Oissso/Robot_MasterProject/README.md

Librarie doit être ajouter dans Documents/Arduino /!\ ce n'est pas toutes les librairies
