Oissso/Robot_MasterProject/Stage robotique Montage robot jour 1 (1).pdf

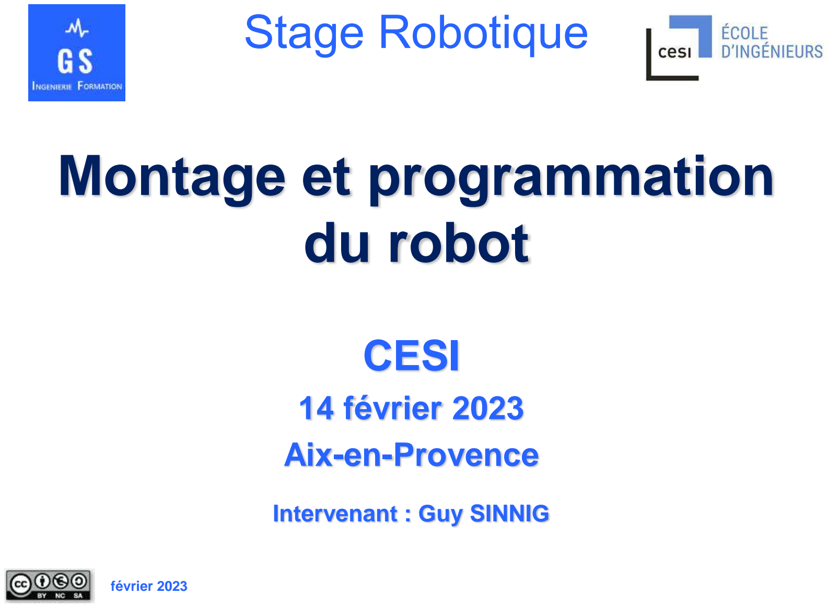
[picture p13: page 1]

février 2023

# Montage et programmation du robot

# CESI

## 14 février 2023 Aix-en-Provence

Intervenant : Guy SINNIG

# Objectif général de la présentation

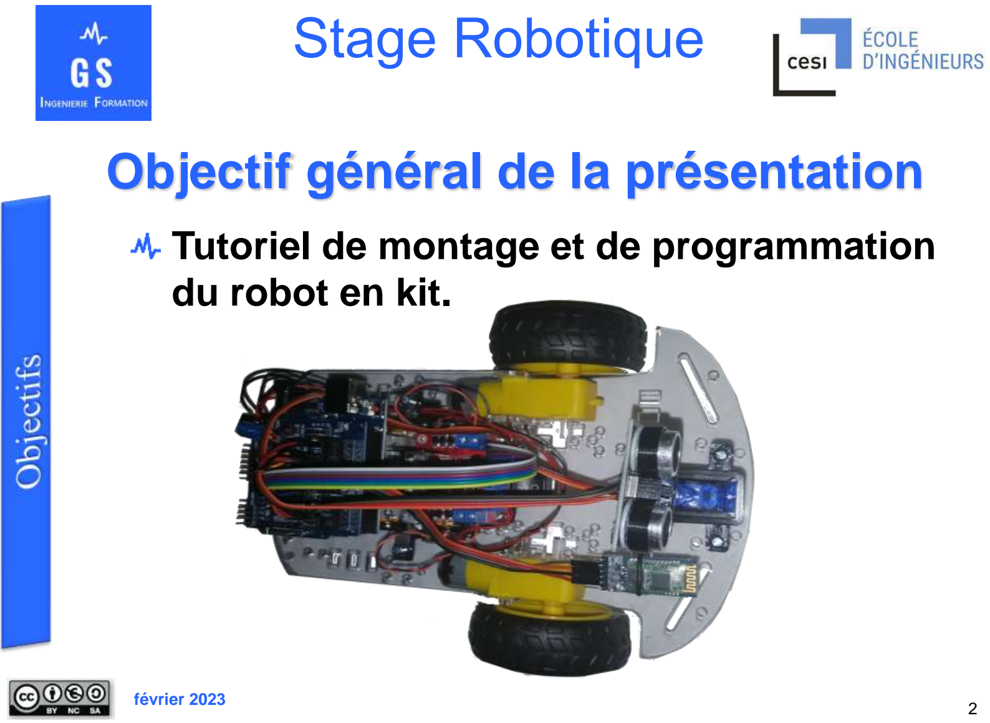
[picture p14: page 2]

## Tutoriel de montage et de programmation

du robot en kit.

# Contenu du kit :

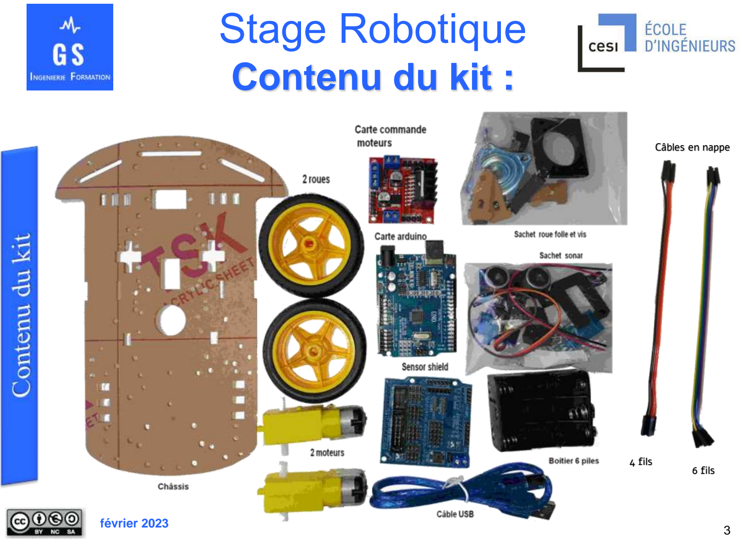
[picture p15: page 3]

février 2023 | 3

Câbles en nappe

4 fils
6 fils

# Contenu du sachet roue folle et vis :

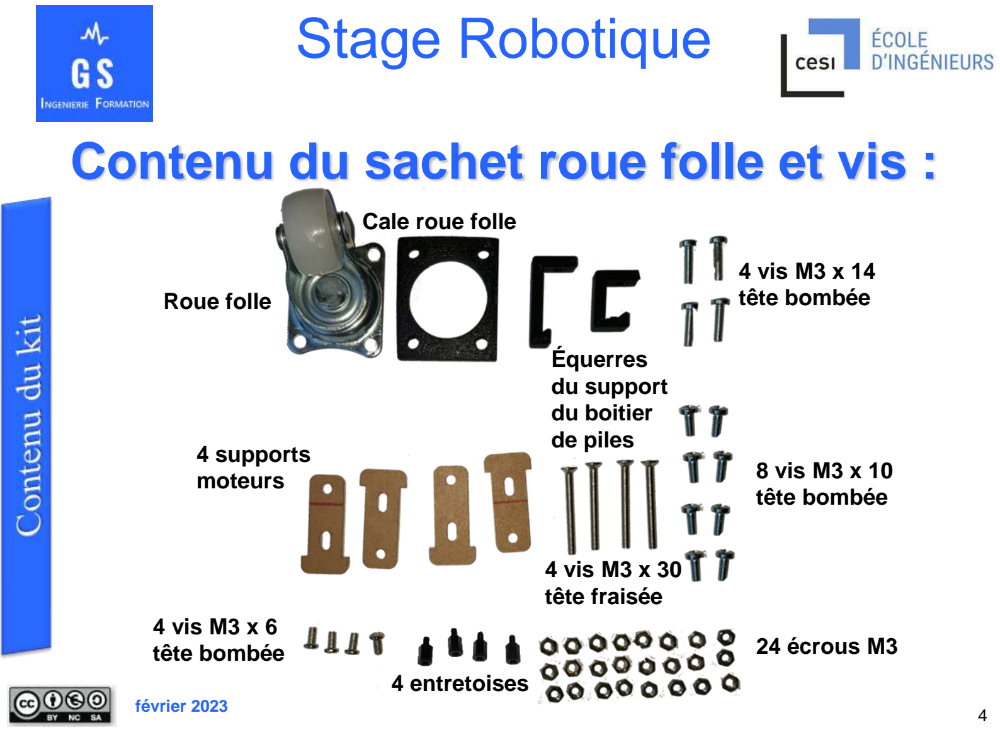
[picture p16: page 4]

février 2023 | 4

Roue folle

### 4 supports

moteurs

Cale roue folle

Équerres
du support
du boitier
de piles

### 4 vis M3 x 14

tête bombée

### 8 vis M3 x 10

tête bombée

### 4 vis M3 x 30

tête fraisée

### 4 vis M3 x 6

tête bombée

### 4 entretoises

### 24 écrous M3

## Contenu du sachet sonar et Interrupteur :

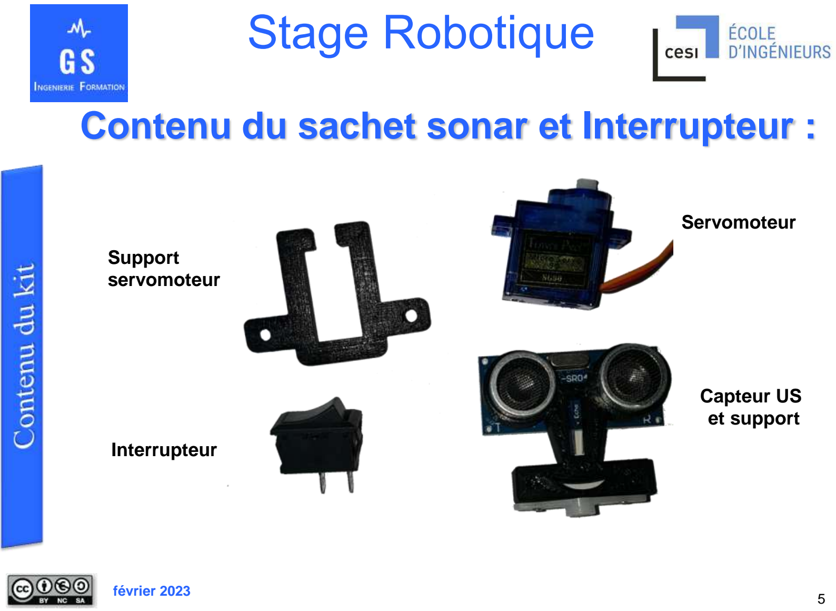
[picture p17: page 5]

février 2023 | 5

Interrupteur

Support
servomoteur

Servomoteur

Capteur US
et support

# Soudure moteurs :

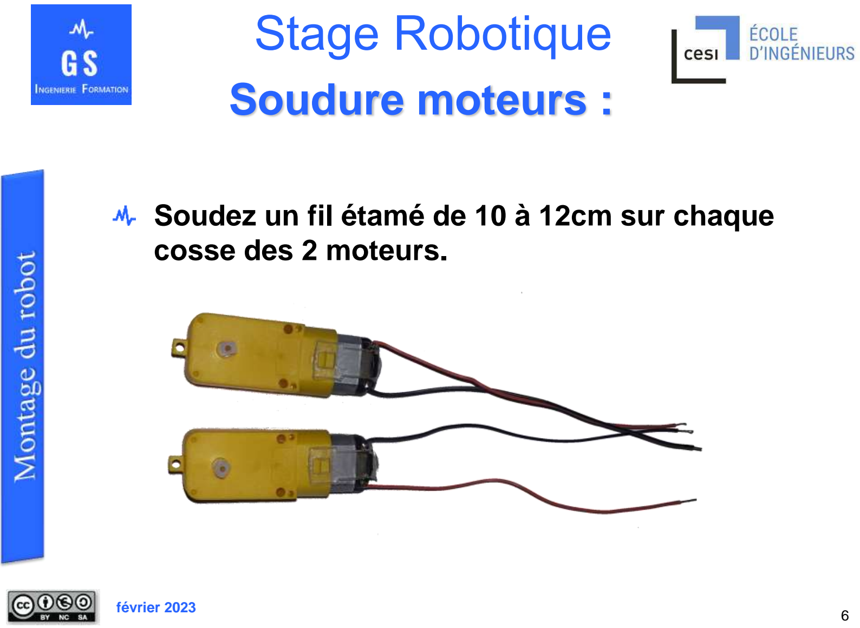
[picture p18: page 6]

### Soudez un fil étamé de 10 à 12cm sur chaque

cosse des 2 moteurs.

# Soudure à l’étain :

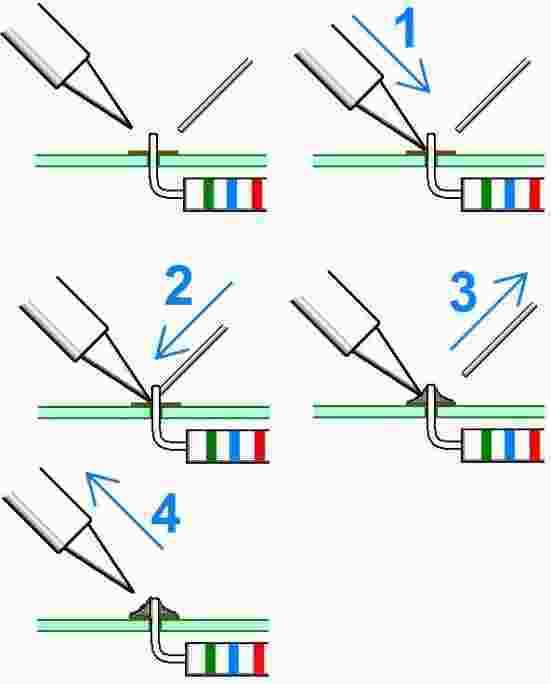
[picture p19: figure]

### - Chauffez le fer à souder :

350 à 400°C.
- Etamez la panne du fer.

### - Enlevez le surplus d’étain

sur la panne.

### - Chauffez la patte du

composant.

### - Faites fondre l’étain sur la

patte chauffée.

# Montage entretoises carte arduino :

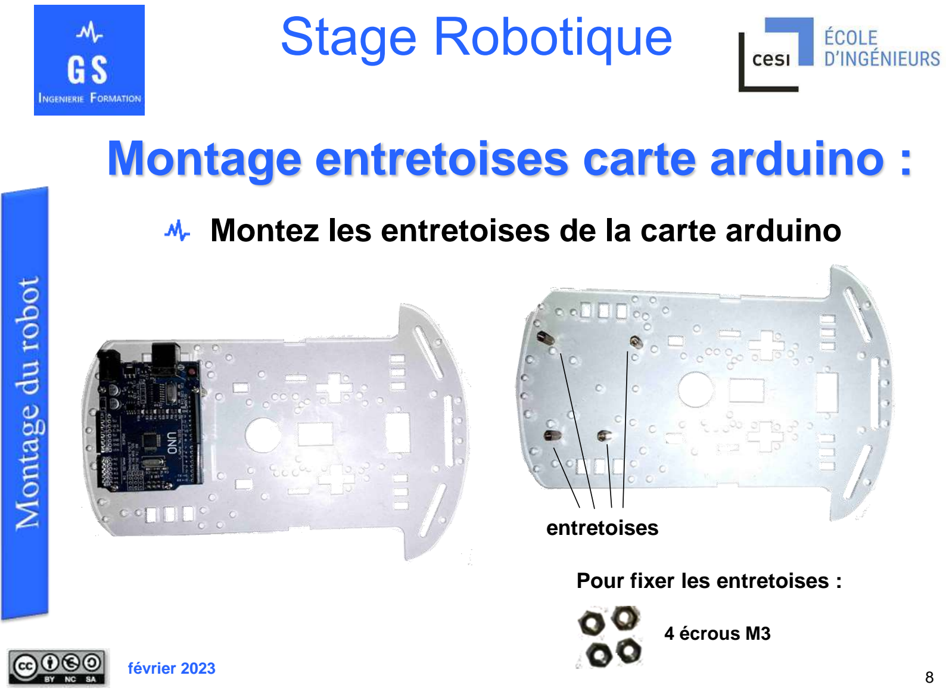
[picture p20: page 8]

### Montez les entretoises de la carte arduino

entretoises

### 4 écrous M3

Pour fixer les entretoises :

# Montage moteurs et roues :

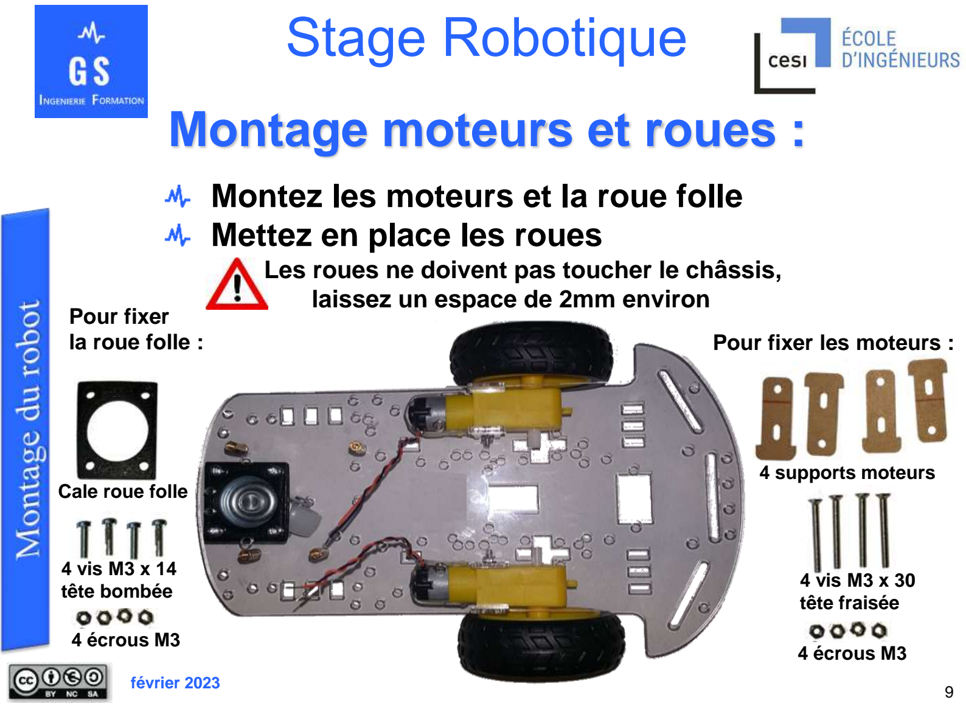
[picture p21: page 9]

### Montez les moteurs et la roue folle Mettez en place les roues

Les roues ne doivent pas toucher le châssis, laissez un espace de 2mm environ

### 4 vis M3 x 30

tête fraisée

### 4 écrous M3 4 écrous M3

### 4 supports moteurs

Pour fixer les moteurs :

Pour fixer
la roue folle :

### 4 vis M3 x 14

tête bombée

Cale roue folle

# Montage carte moteurs …

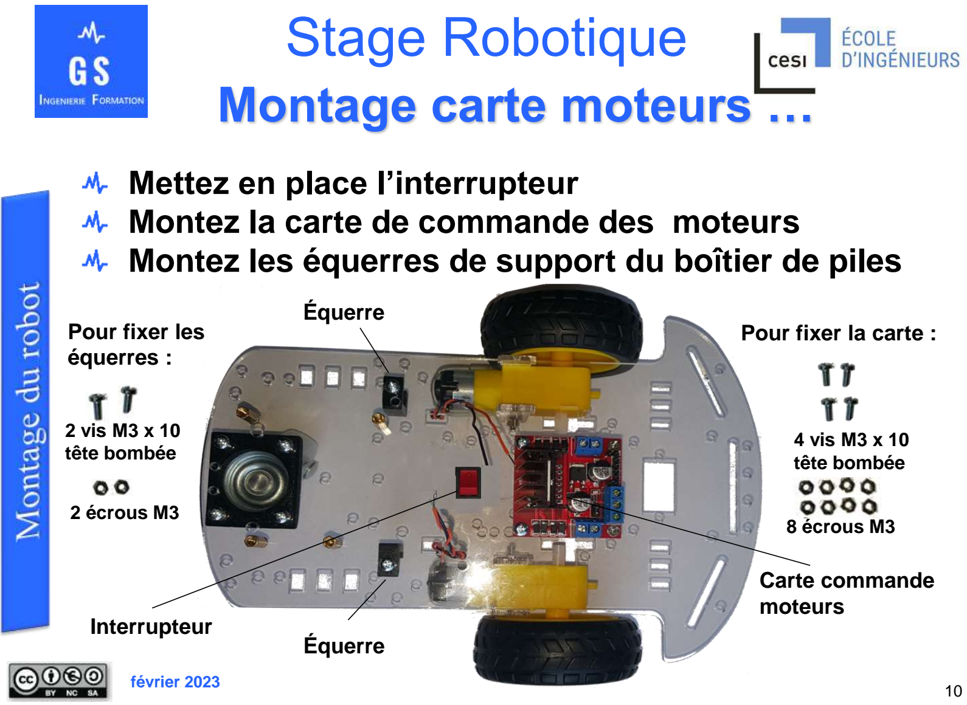
[picture p22: page 10]

### Mettez en place l’interrupteur Montez la carte de commande des moteurs Montez les équerres de support du boîtier de piles

Carte commande
moteurs
Équerre

Équerre

Interrupteur

Pour fixer la carte :

### 4 vis M3 x 10

tête bombée

Pour fixer les
équerres :

### 2 écrous M3

### 2 vis M3 x 10

tête bombée

### 8 écrous M3

# Montage arduino et câblage alimentation

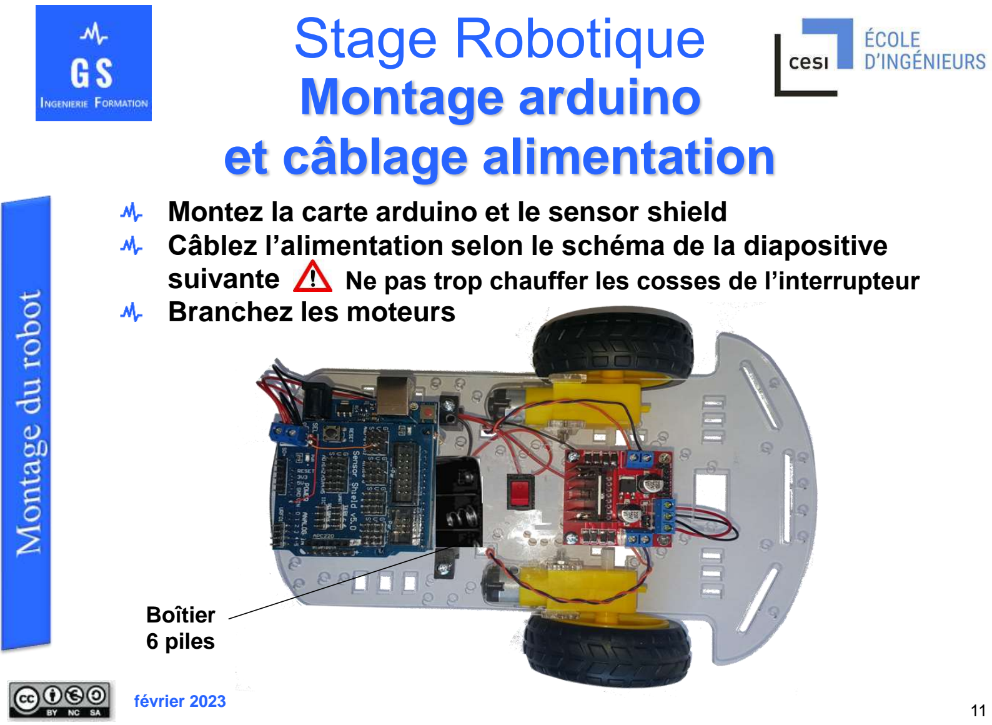
[picture p23: page 11]

Montez la carte arduino et le sensor shield
Câblez l’alimentation selon le schéma de la diapositive suivante
Branchez les moteurs

Ne pas trop chauffer les cosses de l’interrupteur

Boîtier

### 6 piles

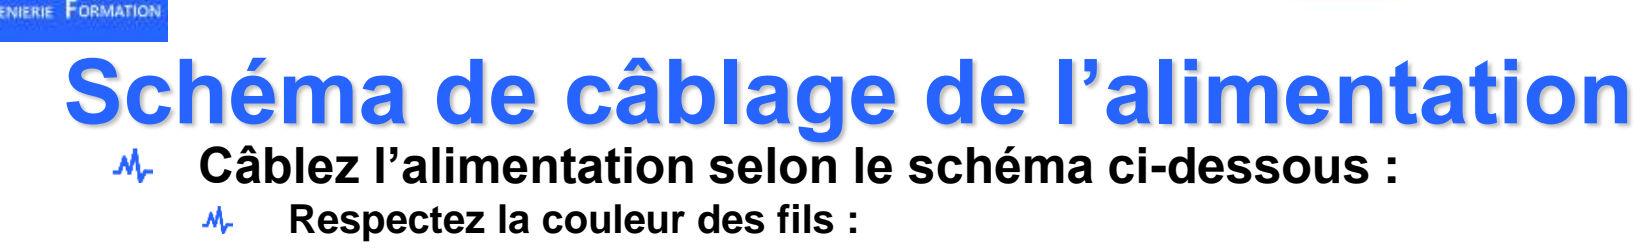
[picture p24: figure]
Schéma de câblage de l’alimentation; Respectez la couleur des fils :

Câblez l’alimentation selon le schéma ci-dessous :

+V | Rouge
GND (0V) | Noir

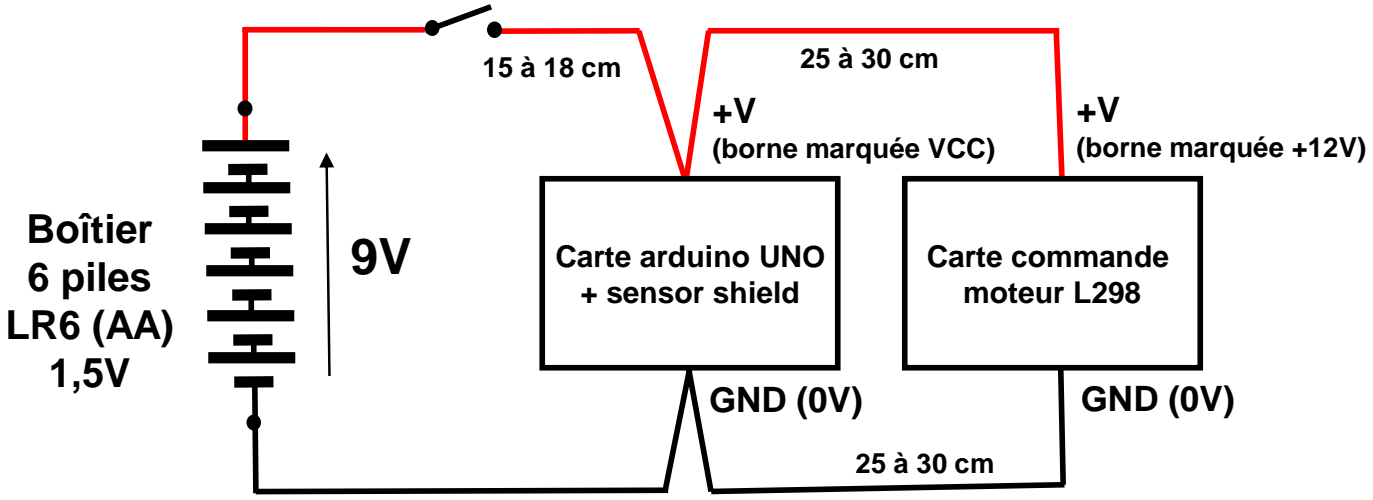
[picture p25: figure]
Carte arduino UNO; + sensor shield; Carte commande moteur L298; Boîtier 6 piles LR6 (AA); GND (0V); (borne marquée VCC); (borne marquée +12V)

Testez le bon fonctionnement de l’ensemble :
Les LED Power des deux cartes doivent être allumées

Ne pas trop chauffer les cosses de l’interrupteur

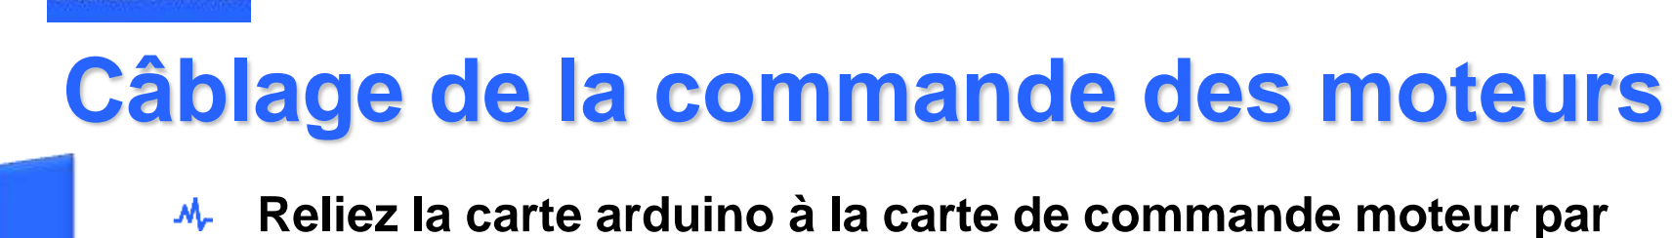
[picture p26: figure]
Câblage de la commande des moteurs

Reliez la carte arduino à la carte de commande moteur par une nappe de 6 fils :

Carte arduino Sensor shield | Carte commande moteurs
3 | ENA
4 | IN1
5 | IN2
6 | IN3
7 | IN4
11 | ENB

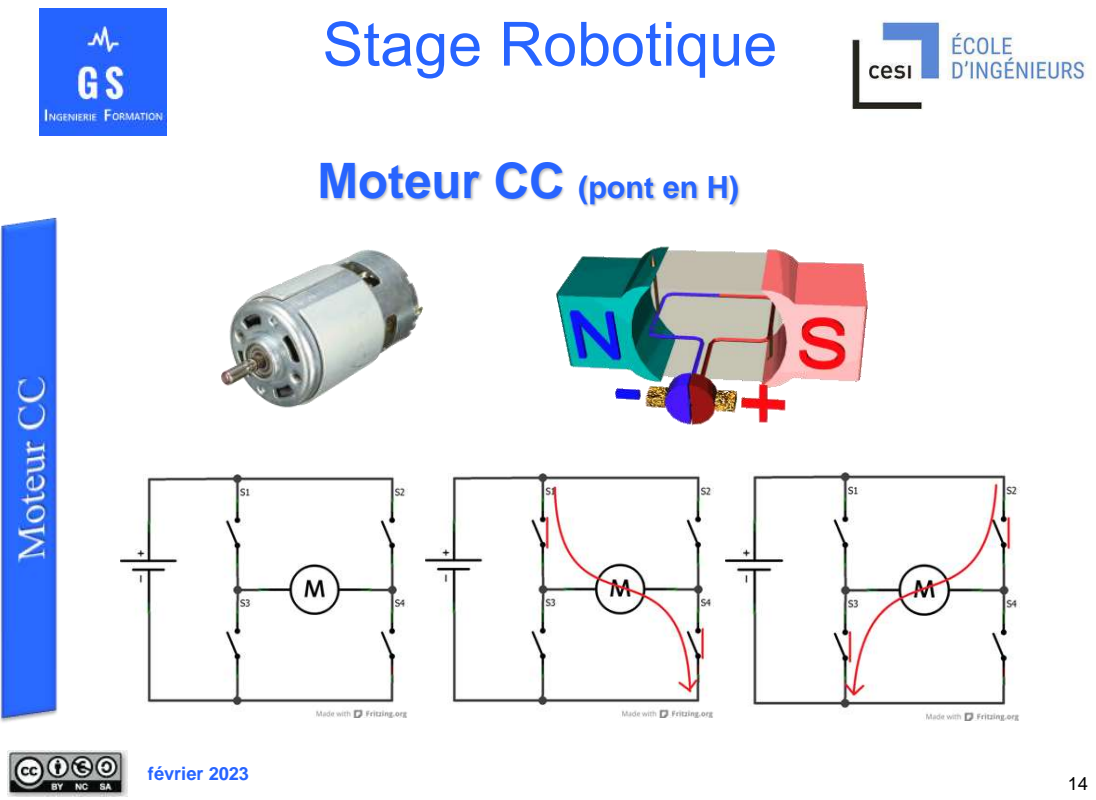
[picture p27: page 14]
février 2023

Moteur CC (pont en H)

## Pont en H

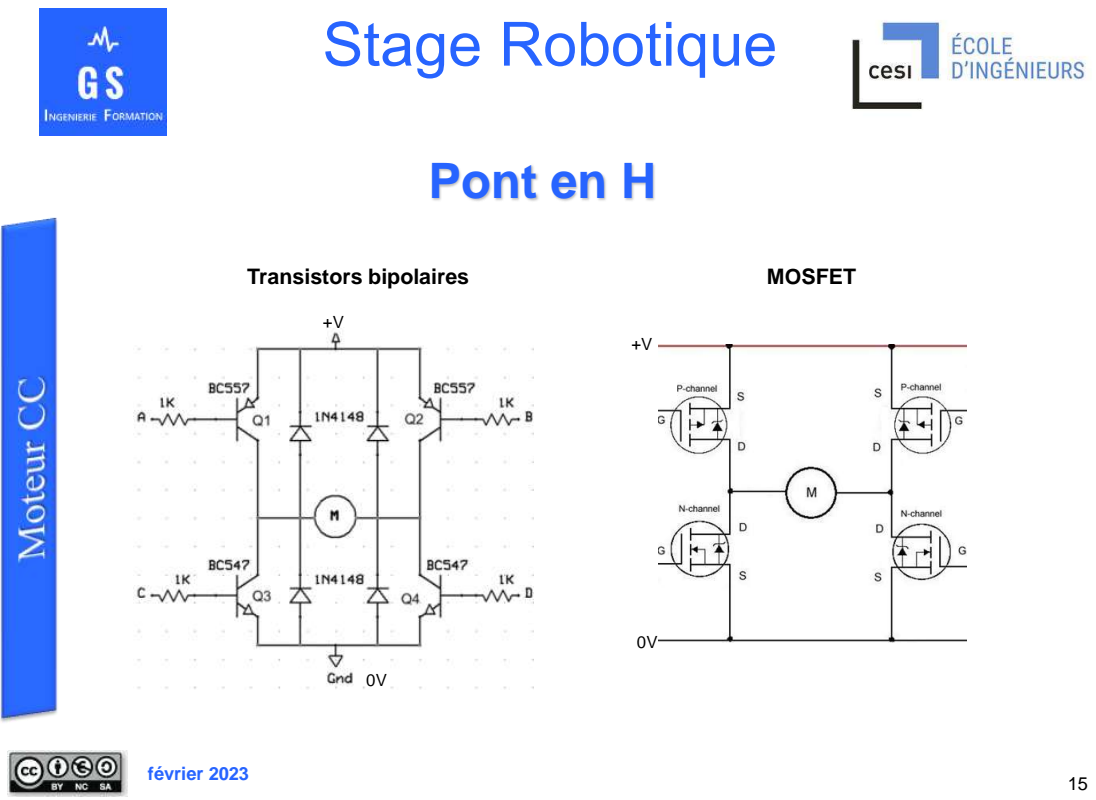
[picture p28: page 15]
février 2023; Transistors bipolaires; MOSFET

## Pont en H

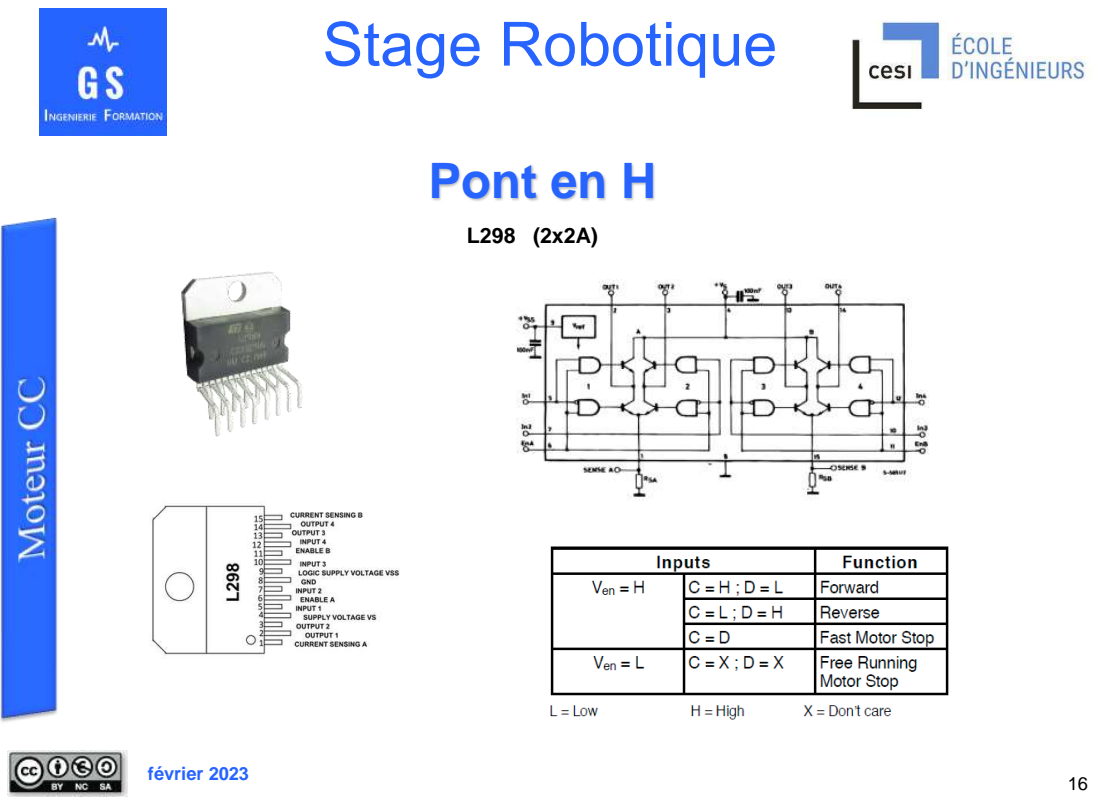
[picture p29: page 16]
février 2023

## Pont en H

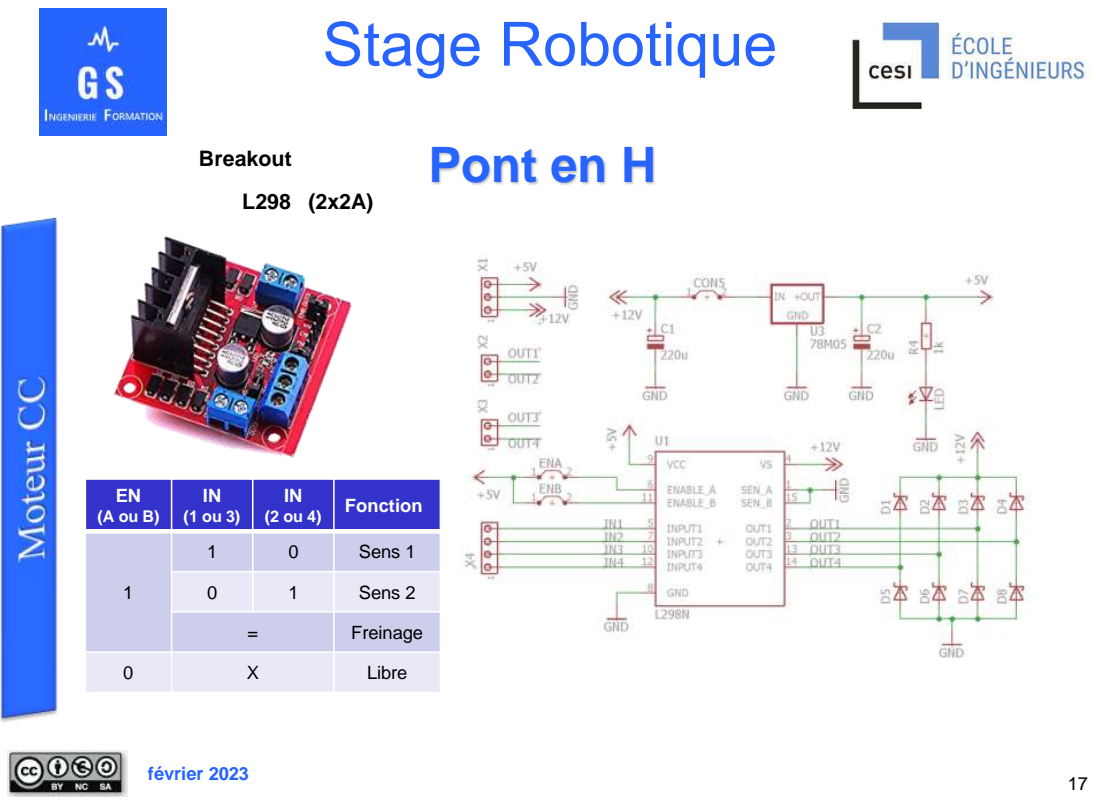
[picture p30: page 17]
février 2023; Breakout

EN (A ou B) | IN (1 ou 3) | IN (2 ou 4) | Fonction

1 | 1 | 0 | Sens 1

0 | 1 | Sens 2

= | | Freinage

0 | X | | Libre

# PWM (Pulse Width Modulation) :

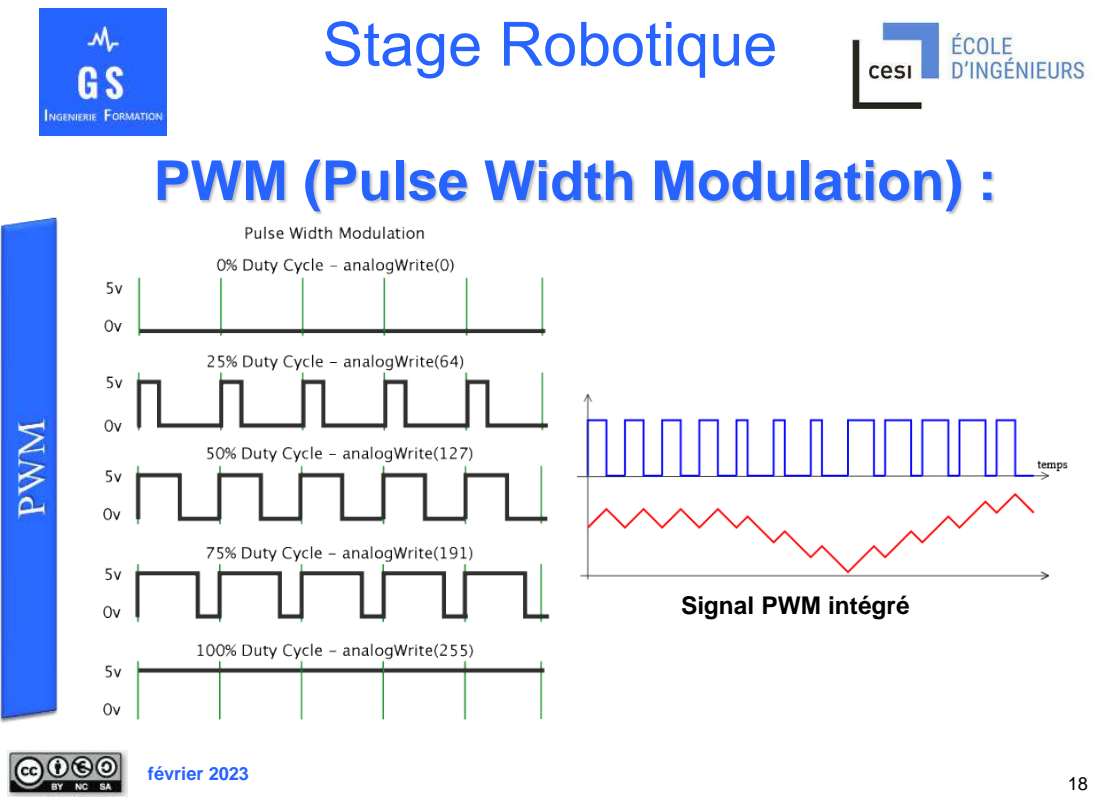
[picture p31: page 18]
février 2023

Signal PWM intégré

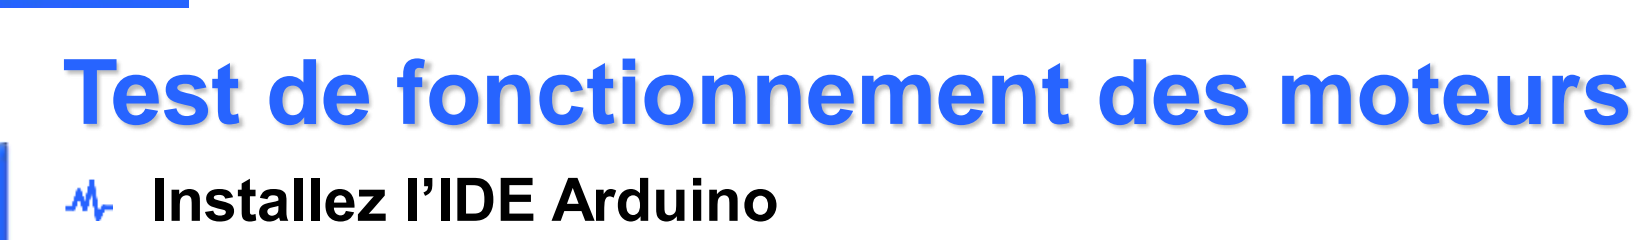
[picture p32: figure]
Test de fonctionnement des moteurs; Installez l’IDE Arduino

### Chargez le driver : CH341SER.EXE fourni

Chargez le programme : Robot-Stage-CESI-Test_Moteurs.ino Vérifiez le bon fonctionnement des moteurs :
Marche avant
Marche arrière

### Modifiez le programme et vérifiez le bon fonctionnement des moteurs :

Marche avant
Marche arrière
Tourner à droite
Tourner à gauche

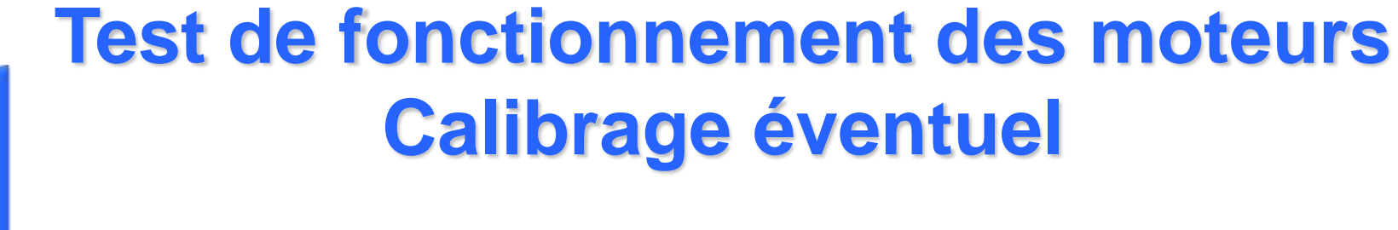
[picture p33: figure]
Test de fonctionnement des moteurs Calibrage éventuel

Chargez le programme : Robot-Stage-CESI-Calibration_Moteurs.ino Si lors du déplacement en marche avant le robot dévie, il faut corriger la commande des moteurs :
Si le robot dévie sur la droite, il faut ralentir le moteur gauche, et inversement.
Les valeurs de commande déterminées seront utilisées pour la suite, lors du fonctionnement du robot.

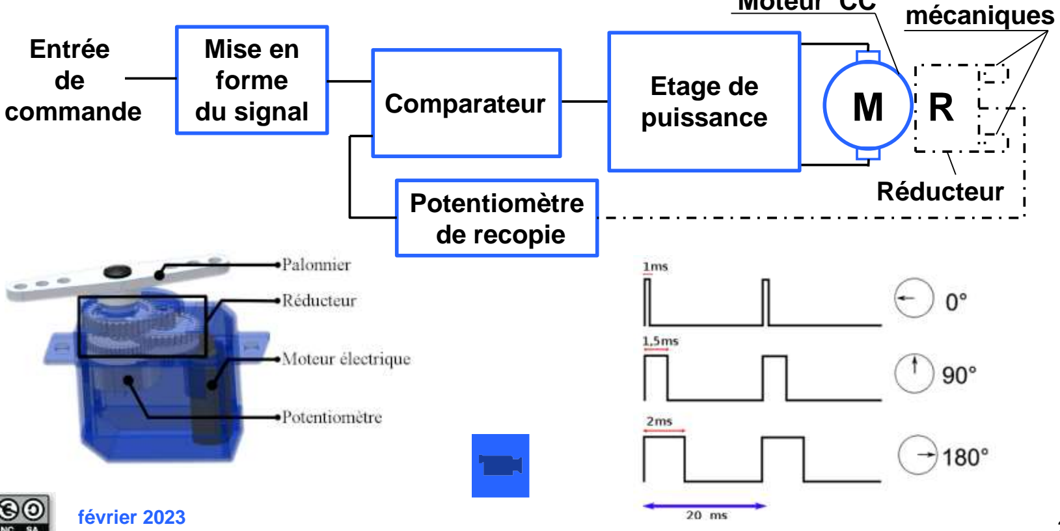
[picture p34: figure]
Mise en forme du signal; Potentiomètre de recopie; Etage de Comparateur; puissance; mécaniques; Entrée de commande; Réducteur

Butées

### Servomoteur standard

Moteur CC

Fixez le support du servomoteur Mettez en place le servomoteur

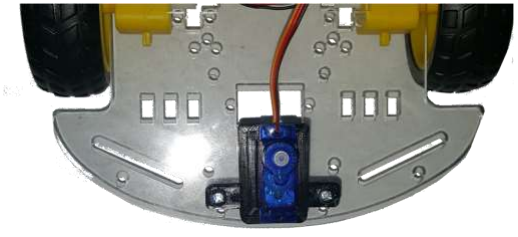
[picture p35: figure]

Pour fixer le support
du servomoteur :

### 2 écrous M3

### 2 vis M3 x 10

tête bombée

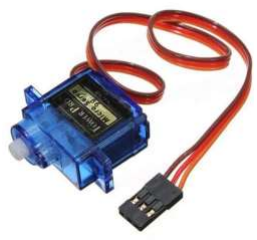
[picture p36: figure]

Chargez le programme : Robot-Stage-CESI-Test_Servo.ino Testez le bon fonctionnement du servo moteur

Carte arduino Sensor shield | Servomoteur S 90
G | Gnd (brun)
V | VCC (rouge)
10 | Cmd (orange)

Branchez le servomoteur :

février 2023 | 24

L'ultrason est une onde mécanique et élastique, qui se propage au travers de supports fluides, solides, gazeux ou liquides. La gamme de fréquences des ultrasons se situe entre 16 000 et 10 000 000 Hertz, trop élevées pour être perçues par l'oreille humaine.
Source : Wikipédia

La vitesse de propagation du son (et donc des ultrasons) dans un milieu gazeux est approximativement c = 20, 05 T T étant la température en degré Kelvin avec (0°K = - 273,15 °C) On a donc : célérité du son pour 20°C c = 20, 05 293, 15 soit c = 343,3 m/s

# Principe de fonctionnement du

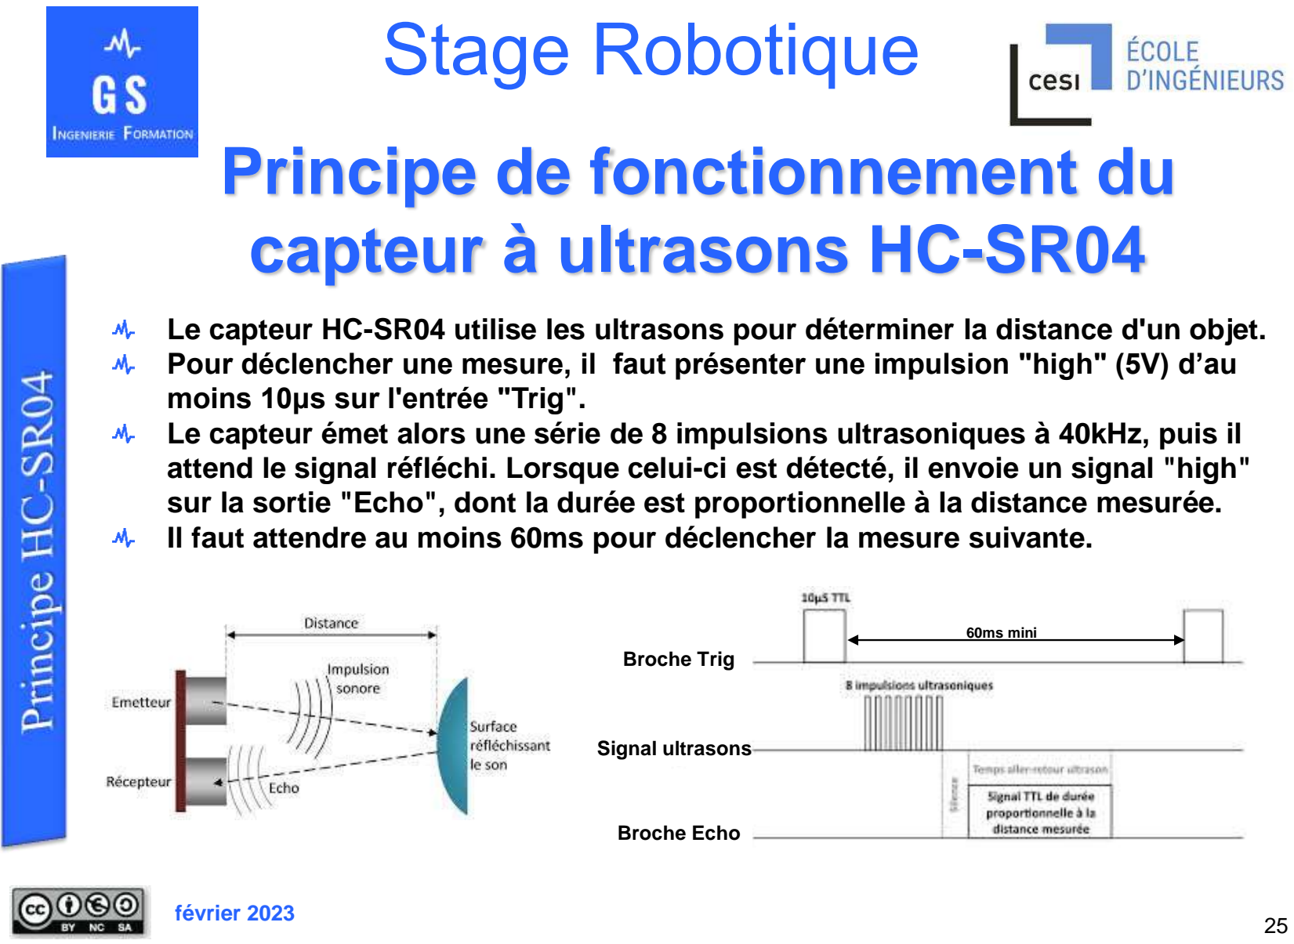
[picture p37: page 25]

février 2023 | 25

# capteur à ultrasons HC-SR04

Le capteur HC-SR04 utilise les ultrasons pour déterminer la distance d'un objet. Pour déclencher une mesure, il faut présenter une impulsion "high" (5V) d’au moins 10μs sur l'entrée "Trig".
Le capteur émet alors une série de 8 impulsions ultrasoniques à 40kHz, puis il attend le signal réfléchi. Lorsque celui-ci est détecté, il envoie un signal "high" sur la sortie "Echo", dont la durée est proportionnelle à la distance mesurée. Il faut attendre au moins 60ms pour déclencher la mesure suivante.

Broche Trig

Signal ultrasons

Broche Echo

60ms mini

Mettez en place le capteur US HC-SR04 Branchez le capteur US :

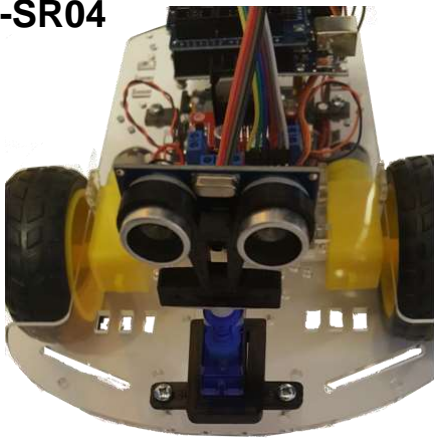
[picture p38: figure]

Chargez le programme : Robot-Stage-CESI-Test_US.ino Testez le bon fonctionnement du capteur US

Carte arduino Sensor shield | Capteur US HC-SR04
G | Gnd
12 | Echo
9 | Trig
V | VCC

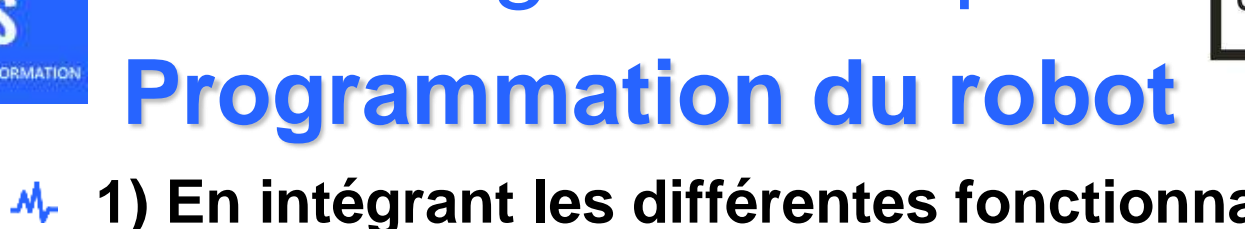
[picture p39: figure]
Programmation du robot

### 1) En intégrant les différentes fonctionnalités des programmes de test, écrivez un programme qui permette au robot de se déplacer en évitant les

obstacles.

### 2) Pour démarrer le robot, il faut mettre la main

devant le capteur US.

### 3) Lorsque le robot détecte un obstacle, il tourne

dans la direction opposée de l’obstacle détecté.

### 4) Le robot démarre lentement et accélère jusqu’à ce qu’il détecte un d’obstacle, il ralenti alors avant de tourner dans la direction opposée de l’obstacle détecté, puis il repart lentement en accélérant …

# Sensor shield V5.0

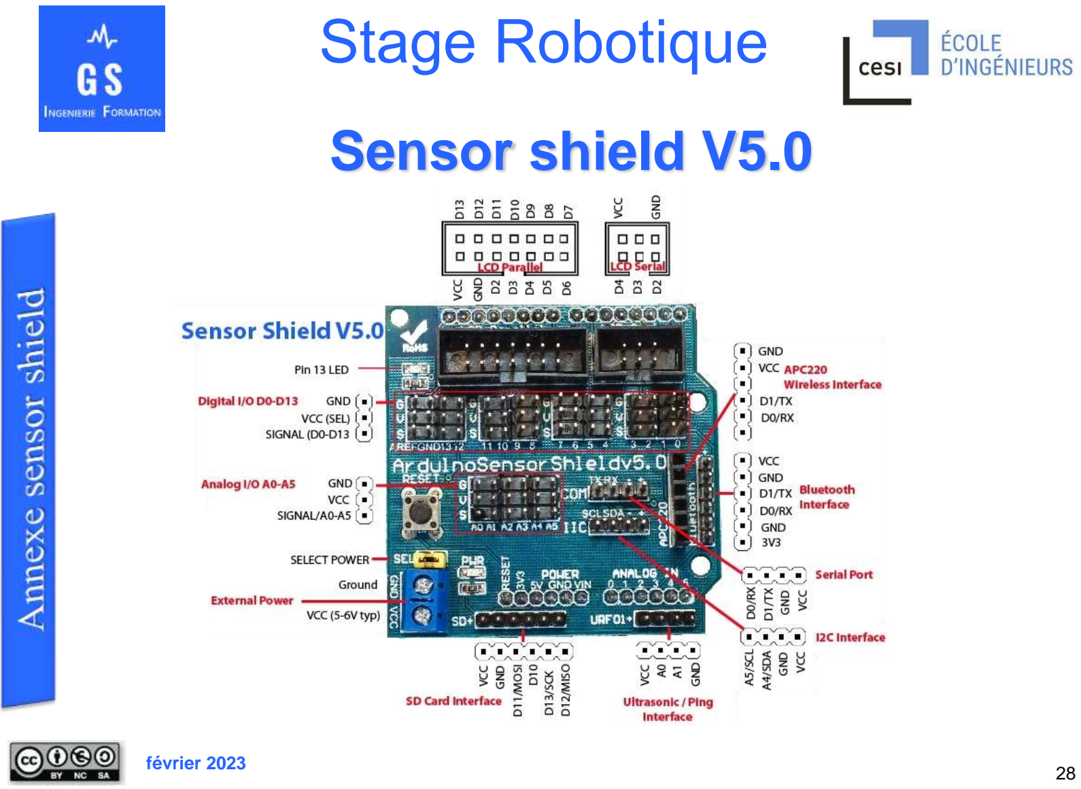
[picture p40: page 28]
