Oissso/Robot_MasterProject/Tutoriel montage robot IA WB55.pdf

# Tutoriel de montage du prototype du robot IA WB55 (base aluminium)

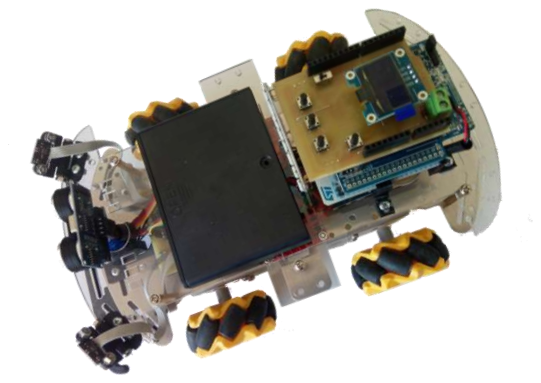
[picture p41: figure]

## Tutoriel de montage du prototype du robot WB55 IA (base aluminium)

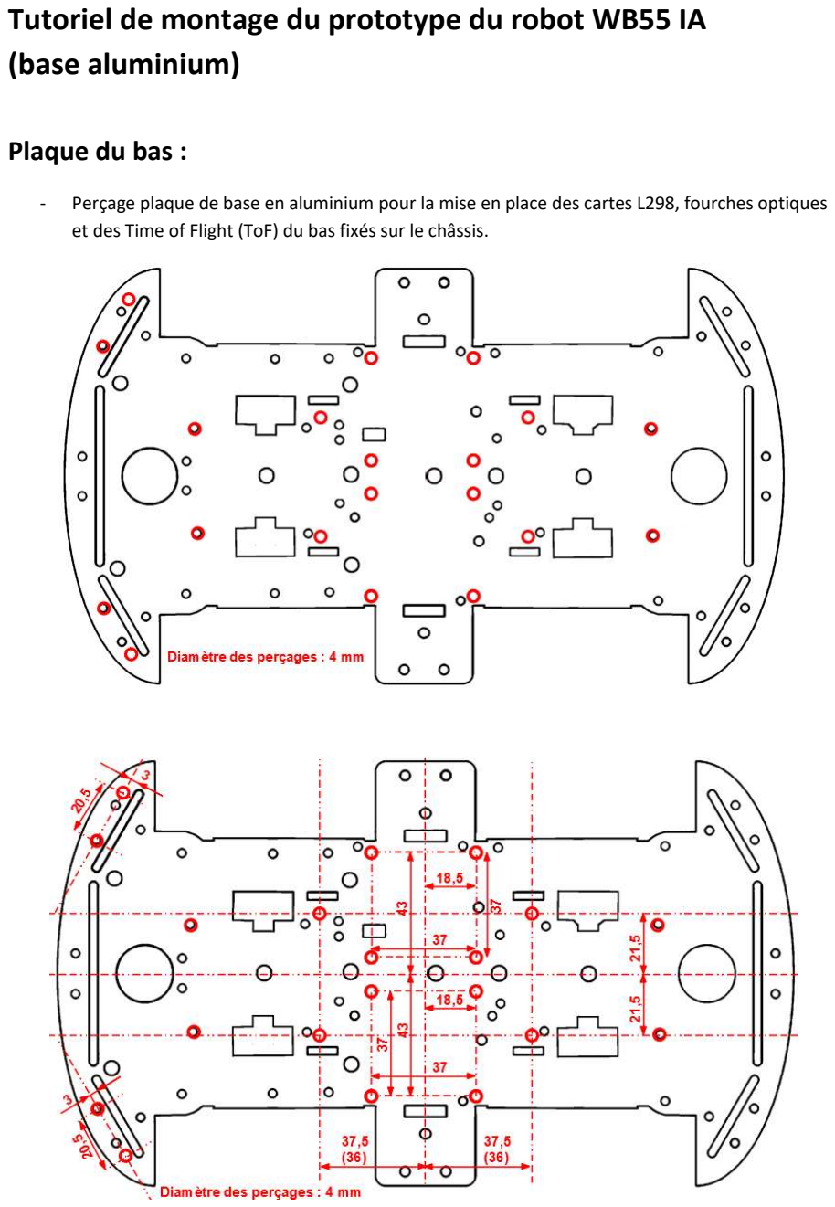
[picture p42: page 2]

## Plaque du bas :

- Perçage plaque de base en aluminium pour la mise en place des cartes L298, fourches optiques et des Time of Flight (ToF) du bas fixés sur le châssis.

- Perçage plaque de base en aluminium pour la mise en place des cartes L298, fourches optiques version sans les Time of Flight (ToF) du bas fixés sur le châssis.

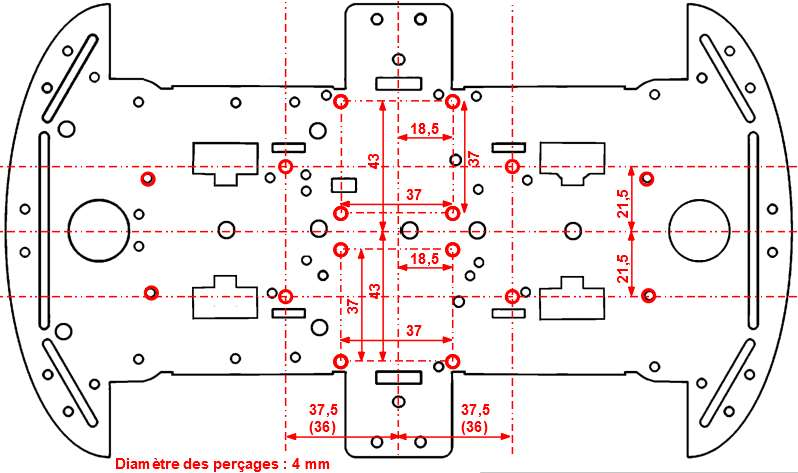
[picture p43: figure]
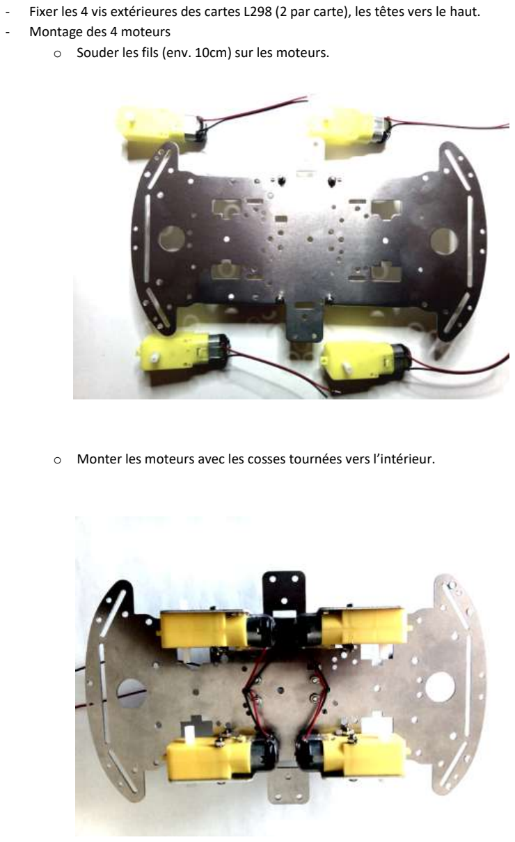
[picture p44: page 4]

- Fixer les 4 vis extérieures des cartes L298 (2 par carte), les têtes vers le haut.
- Montage des 4 moteurs
- Souder les fils (env. 10cm) sur les moteurs.
- Monter les moteurs avec les cosses tournées vers l’intérieur.

- Montage des cartes L298.
- Brancher les moteurs.

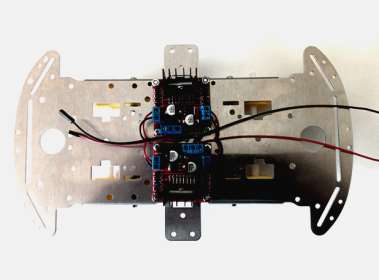
[picture p45: figure]

- Tester le bon fonctionnement des cartes L298 et des moteurs.
- ENA = HIGH ; IN1 = LOW et IN2 = HIGH => moteur AV = Avant
- ENA = HIGH ; IN1 = HIGH et IN2 = LOW => moteur AV = Arrière
- ENB = HIGH ; IN4 = LOW et IN3 = HIGH => moteur AR = Avant
- ENB = HIGH ; IN4 = HIGH et IN3 = LOW => moteur AR = Arrière
- Montage des capteurs fourches optiques.
- Dessouder les connecteurs et les remonter à l’envers (VCC, GND, D0)
- Montage des cartes I2C I/O expander
- Câbler les alimentations :
- GND : (2 x L298) + ( 2 I2C I/O expander) + (4 Fourches optiques) + fil WB55
- + 9V : (2 x L298) + fil WB55
- + 5V : ( I2C I/O expander avant) + (4 Fourches optiques)
- + 3,3V : I2C I/O expander arrière

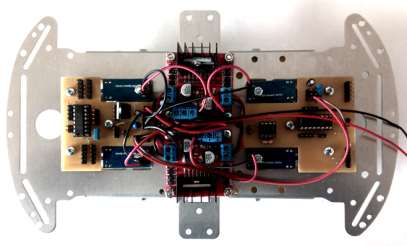
[picture p46: figure]

- Test des cartes I2C I/O expander : Test_PCF8574AP_RobotWB55.ino
=> le moniteur série doit afficher : Init pcf8574 AP 1 ... OK | Init pcf8574 AP 2 ... OK
- Montage des 2 capteurs Time of Flight (TOF) bas.
- Test des TOFs : Test_2TOF_PCF8574AP_RobotWB55.ino
=> le moniteur série doit afficher : les adresses des composants I2C et les distances des TOFs
- Montage du pare choc.

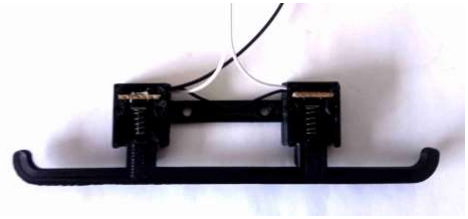
[picture p47: figure]

- Montage du servomoteur S90, après avoir coupé le support arrière du servomoteur.
- Test du servomoteur : Test_servo.ino => le servomoteur doit se déplacer de 0 à 180°.

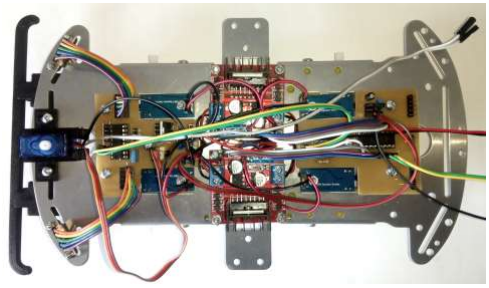
[picture p48: figure]

- Montage du capteur US HC-SR04.
- Test du capteur US : Test_US.ino => le moniteur série doit afficher la distance de l’obstacle en cm.
- Câblage des connexions des commandes moteurs aux cartes L298 :
- L298 droite :
- PCF8574 AP_0 0 = IN4
- PCF8574 AP_0 1 = IN3
- PCF8574 AP_0 2 = IN2
- PCF8574 AP_0 3 = IN1
- Fil Violet = ENA
- Fil Bleu = ENB
- L298 gauche :
- PCF8574 AP_0 4 = IN4
- PCF8574 AP_0 5 = IN3
- PCF8574 AP_0 6 = IN2
- PCF8574 AP_0 7 = IN1
- Fil Blanc = ENA
- Fil Gris = ENB
- Câblage des Fourches optiques D0 :
- FO AVD = Fil Bleu
- FO ARD = Fil Violet
- FO AVG = Fil Vert
- FO ARG = Fil Gris
- Mise en place des 6 entretoises 30mm

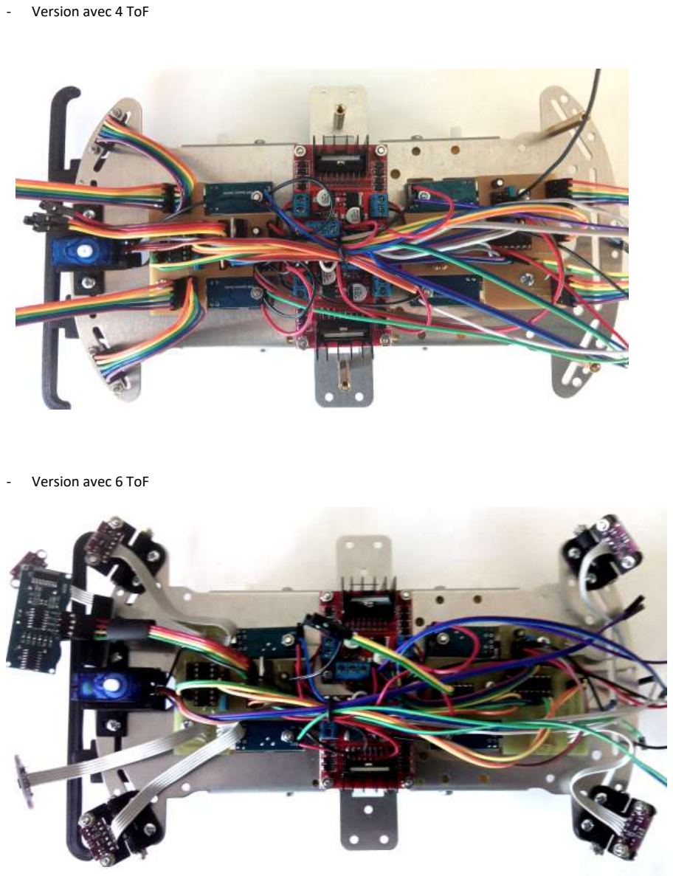
[picture p49: page 8]

- Version avec 4 ToF
- Version avec 6 ToF

## Plaque du haut :

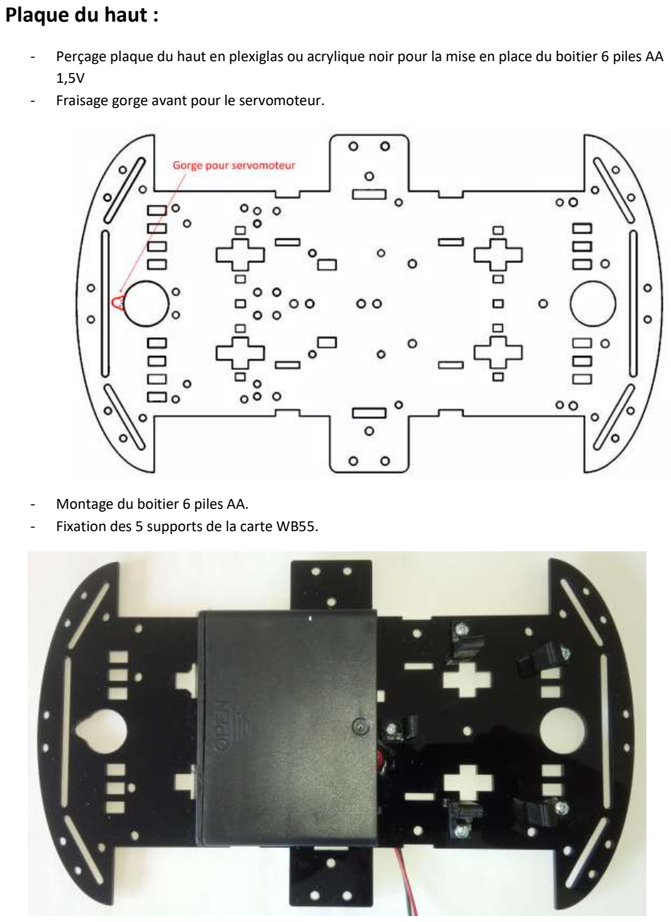
[picture p50: page 9]

- Perçage plaque du haut en plexiglas ou acrylique noir pour la mise en place du boitier 6 piles AA 1,5V
- Fraisage gorge avant pour le servomoteur.
- Montage du boitier 6 piles AA.
- Fixation des 5 supports de la carte WB55.

- Montage des 2 capteurs Time of Flight (ToF) hauts.
- Câblage des 2 ToF du haut.
- Câblage du capteur US.
- Fixation du capteur US sur le servomoteur.
- Câblage des différents éléments la carte WB55

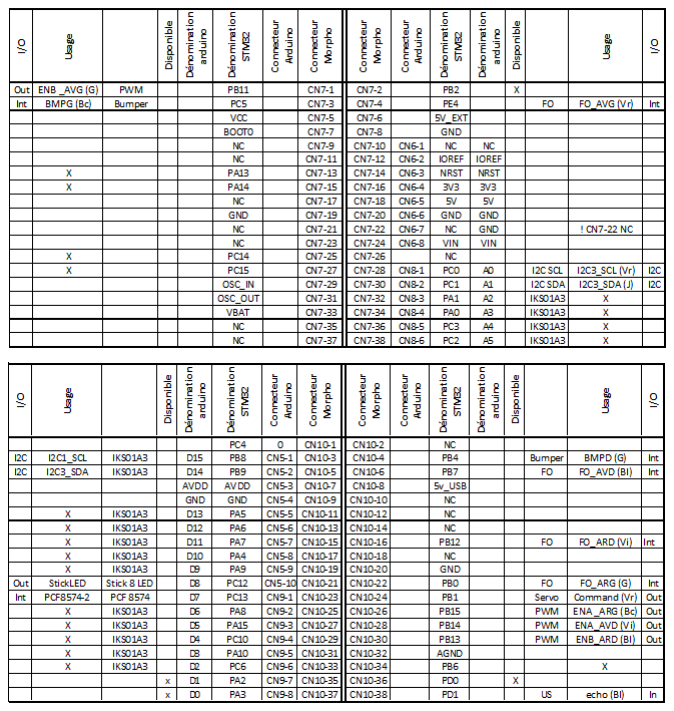
[picture p51: figure]

- Test de fonctionnement de l’afficheur OLED
- Test_OLED_RobotWB55.ino
- Test de fonctionnement du Stick 8 LED RGB
- Test_stick8LED_Neopixel_rainbow_RobotWB55.ino

- Test de fonctionnement des moteurs et des Fourches Optiques
- Test_Moteurs_PCF8574AP_FO_OLED_RobotWB55.ino
- Test de fonctionnement des BP et des Bumper
- Test_BP_Bumper_OLED_RobotWB55_V2.ino
- Mise en place et câblage jack 5.5mm / 2.1mm pour alimentation 9V externe.
- Test des différentes fonctions du robot
- RobotWB55_V2_W1.ino

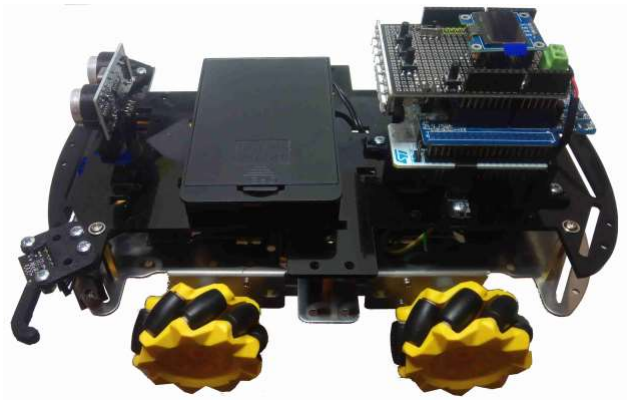
[picture p52: figure]

# Annexes

## PCB carte IHM :

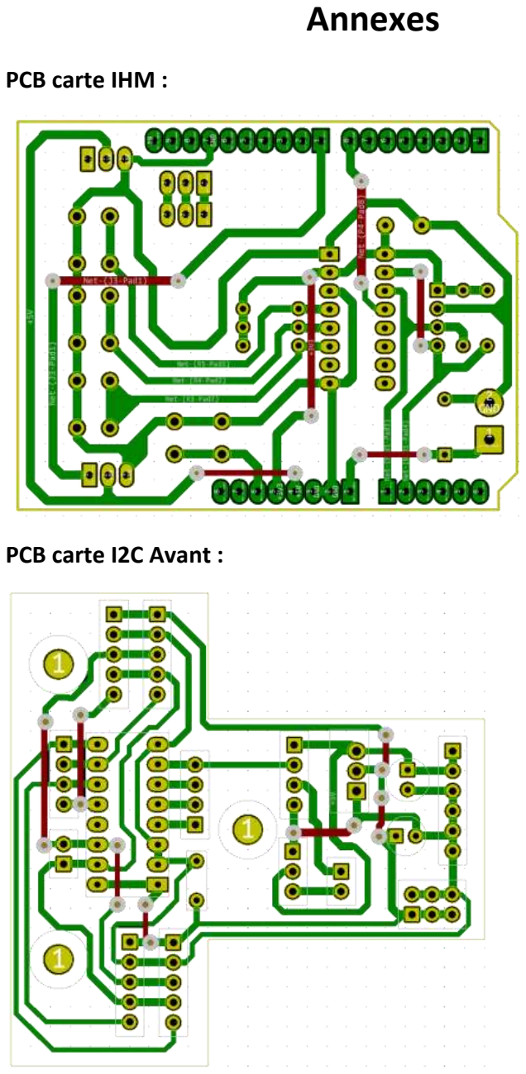
[picture p53: page 12]

## PCB carte I2C Avant :

## PCB carte I2C Arrière :

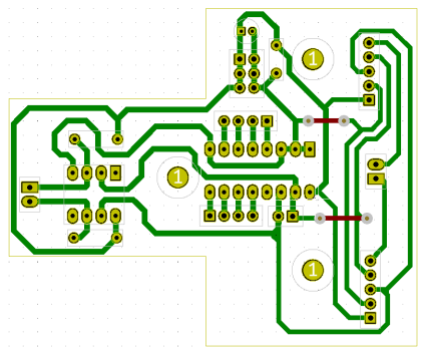
[picture p54: figure]
