Oissso/Robot_MasterProject/Schéma structurel prototype Robot IA WB55.pdf

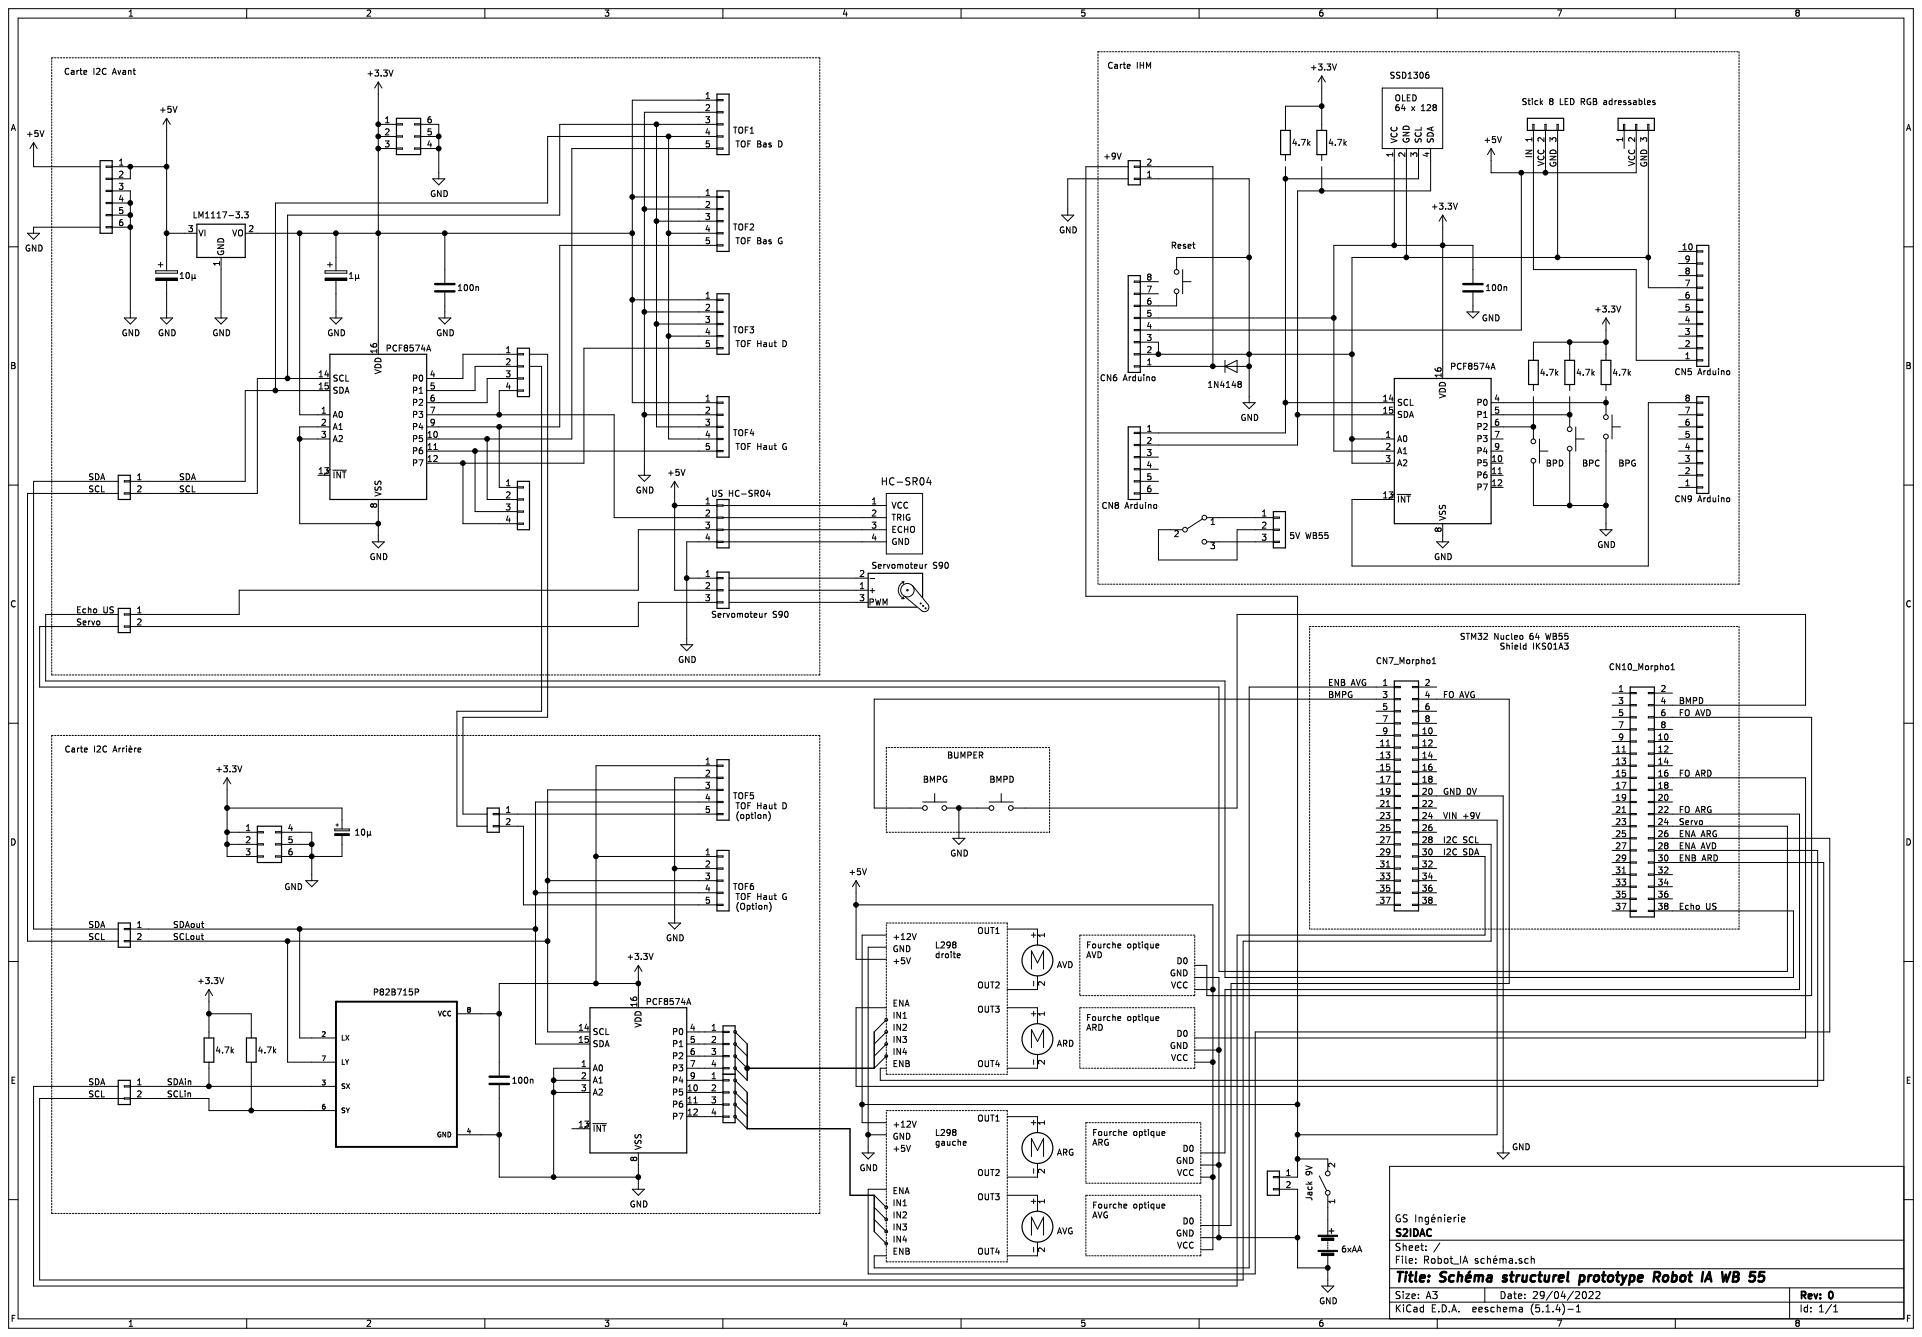
[picture p55: page 1]
